Matthewcerniglia/Agrorobot_electrical_and_hardware/(commit log)

2026-09-23 Create README.md for AgroBot electrical system
    Added comprehensive documentation for the AgroBot's electrical system, including power architecture, safety stack, parts identified, control and communications, and suggested scope of work.
2026-09-23 Fix image path for AgroBot schematic
    Updated image path for AgroBot schematic in README.
2026-11-10 Add files via upload
    uploaded kicad wiring diagram
    [agrobot_master_wiring_diagram.kicad_pcb, agrobot_master_wiring_diagram.kicad_sch, control_tower.kicad_sch]
